duoshock/UM-80/readme.md

# UM-80

UM-80

UM-80 is a split keyboard in 75% layout with RGB, macro keys, OLED screen and encoder housed in PLA 3D printed cases sold by [Merge](https://mergedesign.store/products/um-80).
