duoshock/UM-80/Print files/STL/6 Degree Risers/UM80_L_Riser_6Degree_v5.STL

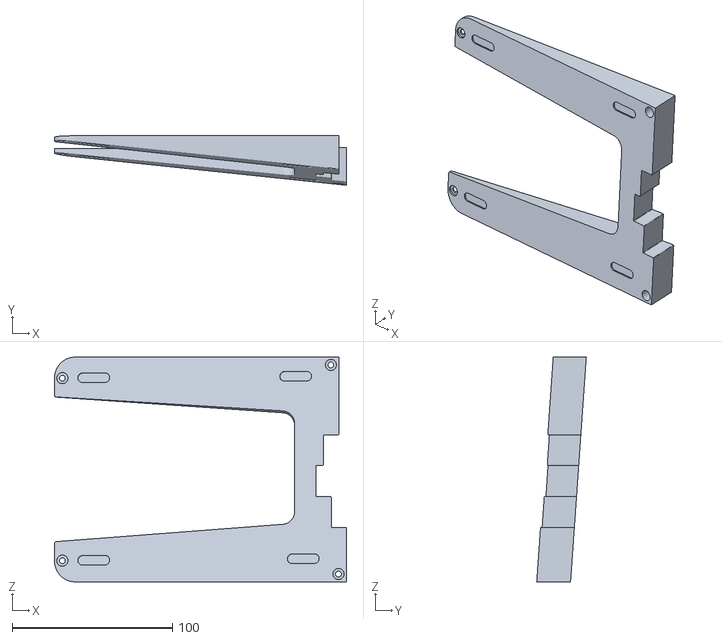
[picture p2: CAD file, 2022-05-08]
Print files/STL/6 Degree Risers/UM80_L_Riser_6Degree_v5.STL
182.4 x 31.0 x 140.4
