duoshock/UM-80/Print files/STL/Cases/UM80_L_Case_v5.STL

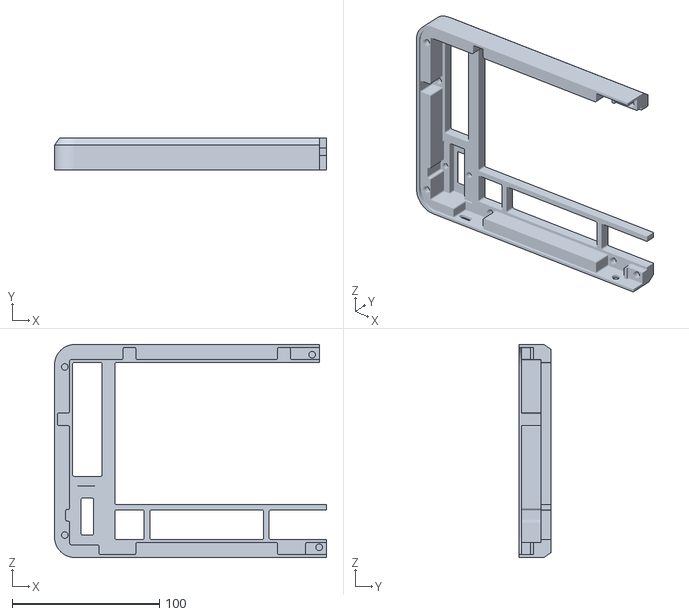
[picture p3: CAD file, 2022-05-08]
Print files/STL/Cases/UM80_L_Case_v5.STL
184.5 x 22.0 x 144.6
