duoshock/UM-80/Print files/STL/Knob/UM-80_Knob_v2.STL

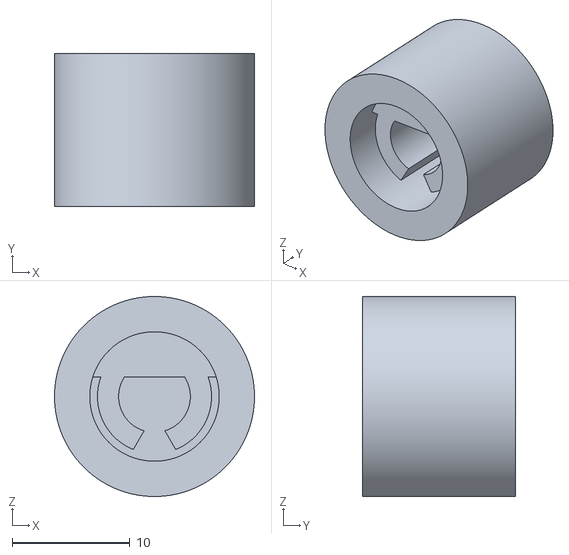
[picture p5: CAD file, 2022-05-08]
Print files/STL/Knob/UM-80_Knob_v2.STL
17.0 x 13.0 x 17.0
