duoshock/UM-80/Print files/STL/Panels/UM80_L_Panel_v5.STL

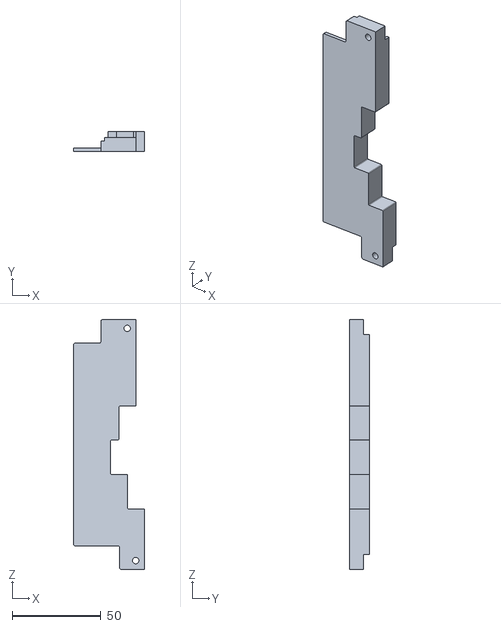
[picture p6: CAD file, 2022-05-08]
Print files/STL/Panels/UM80_L_Panel_v5.STL
40.0 x 11.4 x 140.6
