duoshock/UM-80/Print files/STL/Plates/UM80_L_Plate_v5.STEP

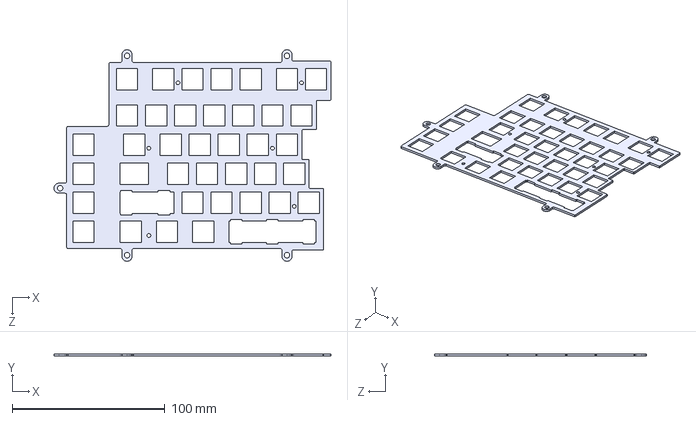
[picture p7: CAD file, 2023-09-09]
Print files/STL/Plates/UM80_L_Plate_v5.STEP
181.5 x 1.60 x 138.6 mm
