duoshock/UM-80/Print files/STL/4 Degree Risers/UM80_R_Riser_4Degree_v5.STL

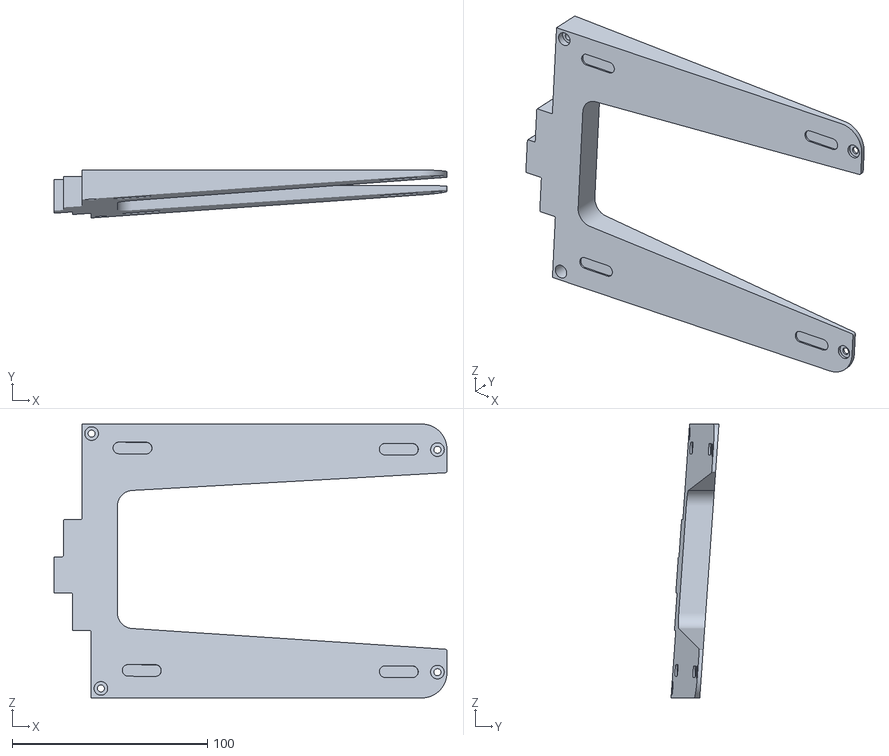
[picture p8: CAD file, 2022-05-08]
Print files/STL/4 Degree Risers/UM80_R_Riser_4Degree_v5.STL
201.4 x 24.6 x 140.4
