duoshock/UM-80/Print files/STL/6 Degree Risers/UM80_R_Riser_6Degree_v5.STL

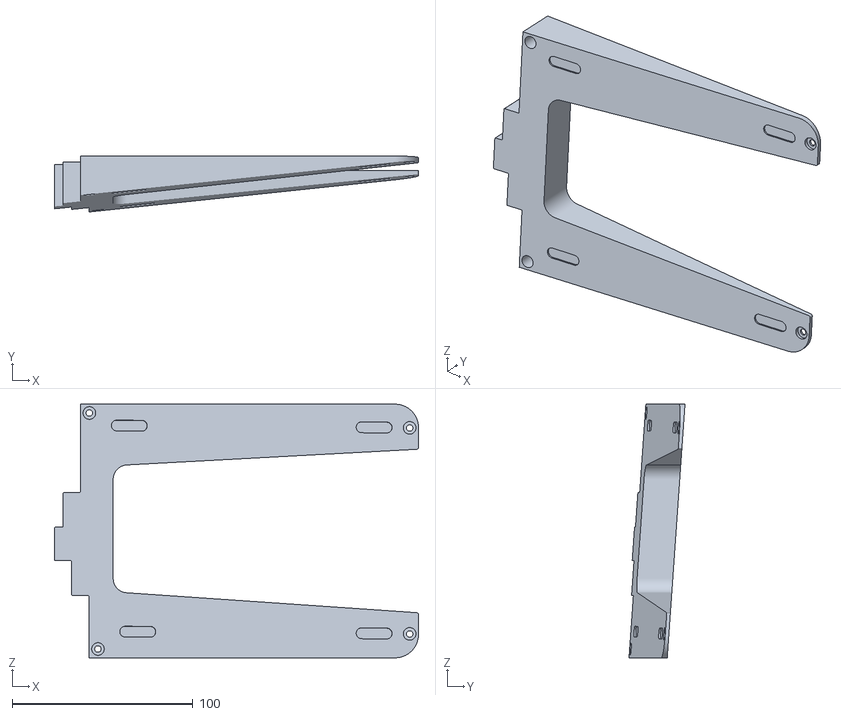
[picture p9: CAD file, 2022-05-08]
Print files/STL/6 Degree Risers/UM80_R_Riser_6Degree_v5.STL
201.4 x 31.0 x 140.4
