duoshock/UM-80/Print files/STL/Cases/UM80_R_Case_v5.STL

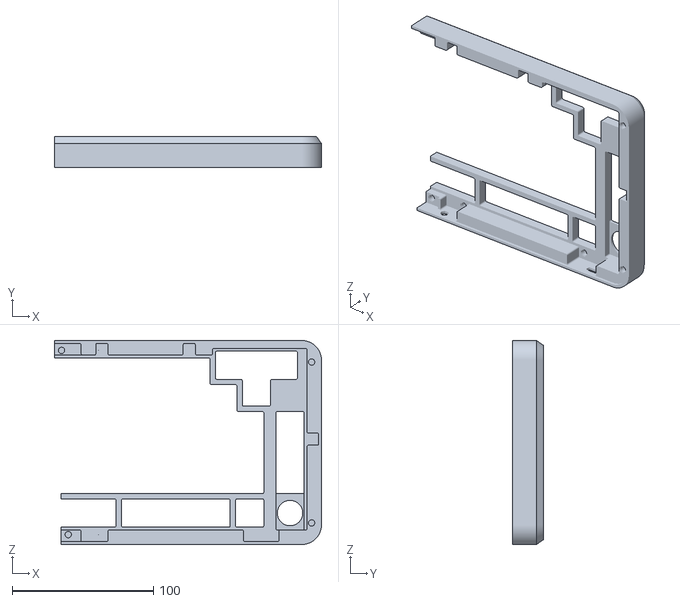
[picture p10: CAD file, 2022-05-08]
Print files/STL/Cases/UM80_R_Case_v5.STL
189.3 x 22.0 x 144.6
