duoshock/UM-80/Print files/STL/Covers/UM80_R_Cover_v5.STL

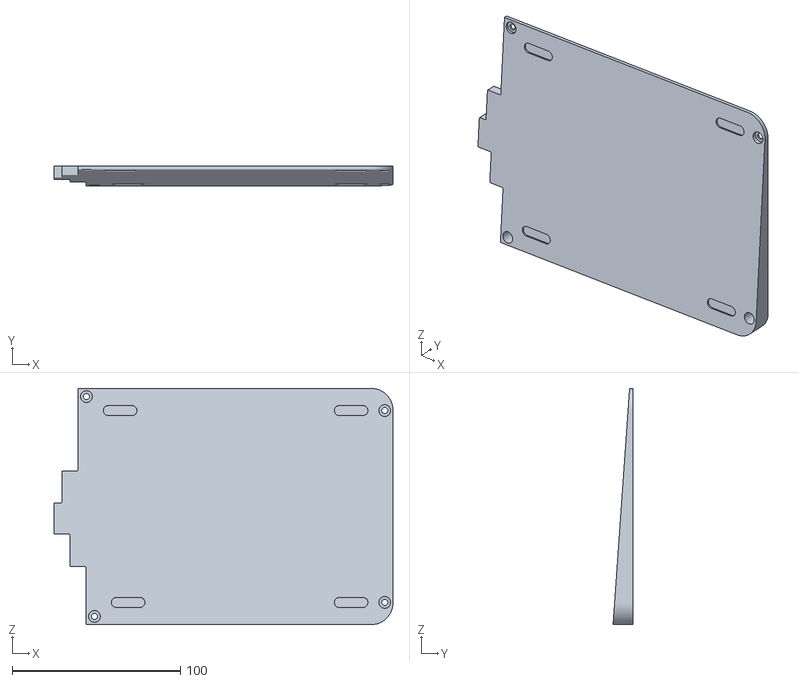
[picture p11: CAD file, 2022-05-08]
Print files/STL/Covers/UM80_R_Cover_v5.STL
201.4 x 11.8 x 140.4
