duoshock/UM-80/Print files/STL/Plates/UM80_R_Plate_v5.STEP

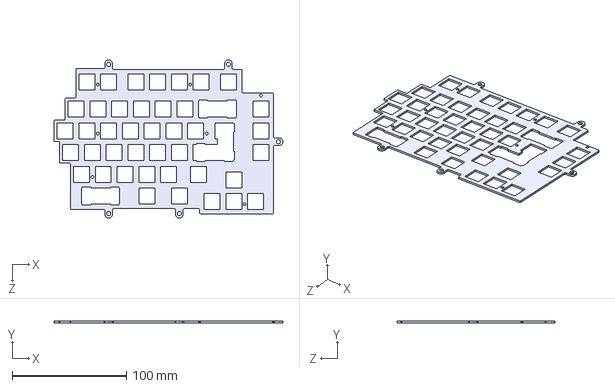
[picture p12: CAD file, 2023-09-09]
Print files/STL/Plates/UM80_R_Plate_v5.STEP
200.5 x 1.60 x 138.6 mm
