duoshock/UM-80/(list of files, cad)

Other CAD files:
Print files/STL/Panels/UM80_R_Panel_v5.STL
