duoshock/UM-80/Print files/readme.md

# **Print guide**

## **Print files**

There are 7 parts need to be printed in order to complete the build.
- Left & right cases
- Left & right covers
- Left & right panels
- Knob
- Risers (Optional)

## **Recommended print setting**
<a href="img/UM80_Print_Ori.jpg">
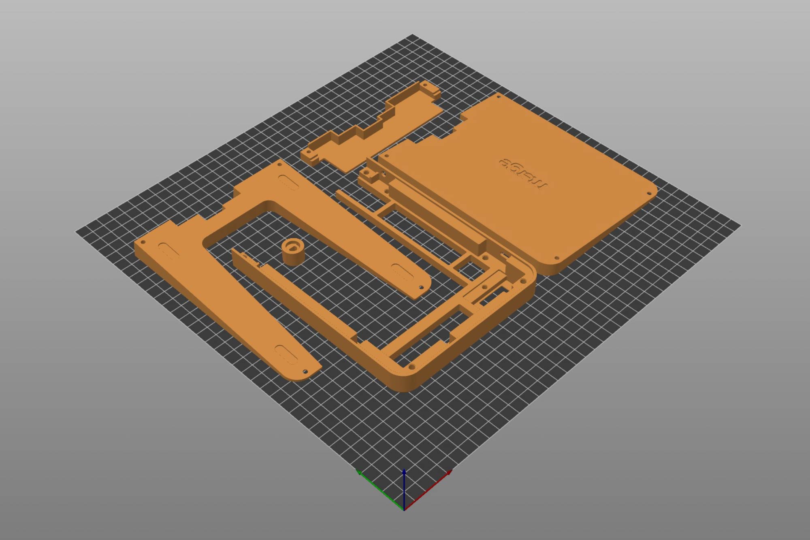
[picture p13: Print files/img/UM80_Print_Ori.jpg]

</a>

Print Orientation

- Minimum build volume: 200 x 145 x 23mm
- 0.4mm Nozzle
- 0.2mm layer height
- ≥ 15% infill

All parts are designed to be printed with 0.4 nozzle at 0.2mm layer height without support, see print orientation.

## **Thread Inserts**
<a href="img/UM80_Print_Insert_L.jpg">
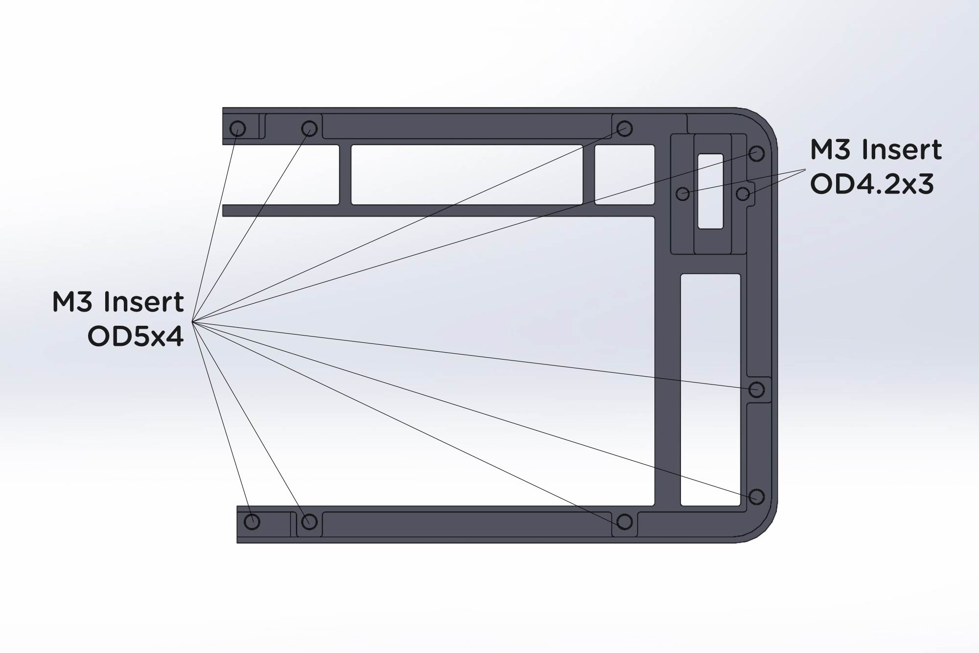
[picture p14: Print files/img/UM80_Print_Insert_L.jpg]

</a>
<a href="img/UM80_Print_Insert_R.jpg">
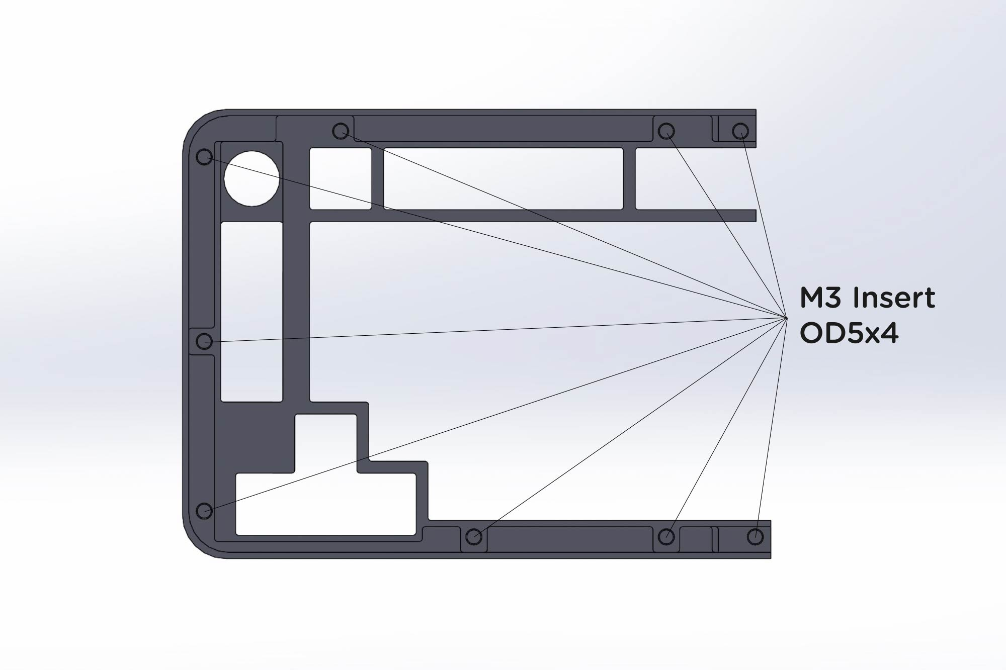
[picture p15: Print files/img/UM80_Print_Insert_R.jpg]

</a>

PCB kit comes with heat-set threaded inserts for both halves. All mount holes are designed to accept M3 OD5 x H4 except OLED mounts which is OD4.2 x H3. See above for details.
